the-mad-hatters/defcon2024badge/hardware/mad_hatter_lower_back_v3.png

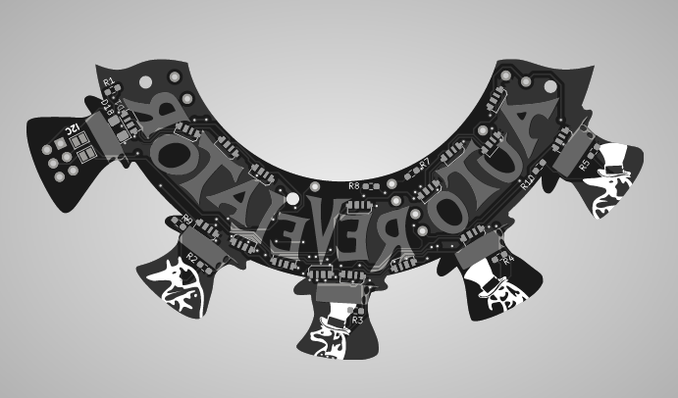
hardware/mad_hatter_lower_back_v3.png
