the-mad-hatters/defcon2024badge/hardware/mad_hatter_main_back.png

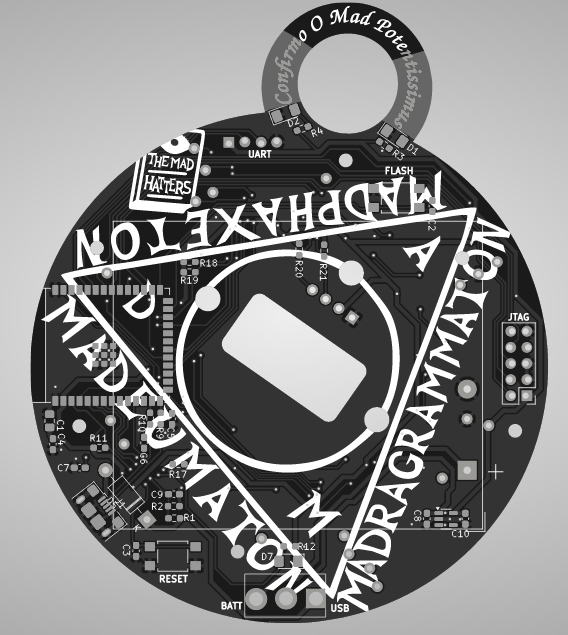
hardware/mad_hatter_main_back.png
