the-mad-hatters/defcon2024badge/README.md

# defcon2024badge

See https://madhatters.lol for details

The Mad Hatter Auto Revelator badge and Madragrammaton SAO will be available at the Hacker Warehouse at DC32.
