the-mad-hatters/defcon2024badge/stl/README.md

3D-Print: Top Hats and Adapters

* Print-ready for badge: :point_right: `tophat_dc32_badge.stl`

* Print-ready for SAO: :point_right: `tophat_dc32_sao.stl`

  * https://www.printables.com/model/935801

  * This work is licensed under a Creative Commons (4.0 International License) Attribution

    * ✖ | Sharing without ATTRIBUTION
    * ✔ | Remix Culture allowed
    * ✔ | Commercial Use
    * ✔ | Free Cultural Works
    * ✔ | Meets Open Definition

  * Remixed from (Attribution for original source creator: lytta, CC 4.0): https://www.printables.com/en/model/537438

* Adapter for swapping out hats - board side: :point_right: `madhatter_board_adapter.stl`

* Adapter for swapping out hats - hat side: :point_right: `madhatter_hat_adapter.stl`

  * https://www.printables.com/model/964691

  * This work is licensed under a Creative Commons (4.0 International License) Attribution-ShareAlike

    * ✖ | Sharing without ATTRIBUTION
    * ✔ | Remix Culture allowed
    * ✔ | Commercial Use
    * ✔ | Free Cultural Works
    * ✔ | Meets Open Definition

  * Remixed from (Attribution for original source creator: Mat, CC 4.0): https://www.printables.com/model/501739
