the-mad-hatters/defcon2024badge/hardware/mad_hatter_main_front.png

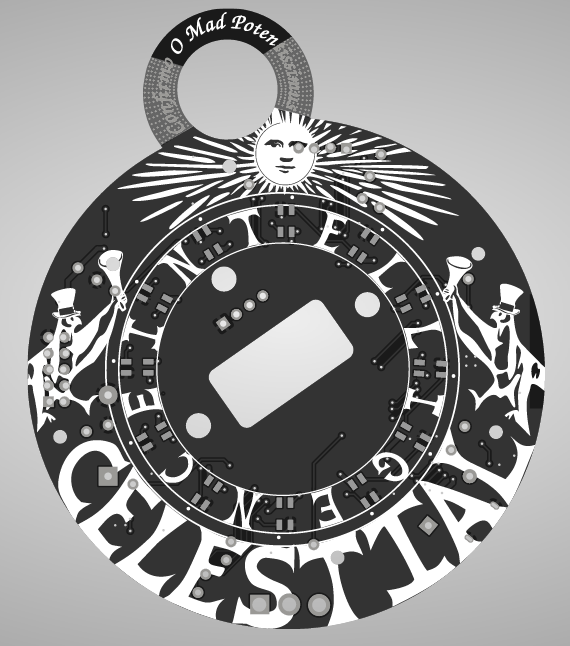
hardware/mad_hatter_main_front.png
