the-mad-hatters/defcon2024badge/hardware/mad_hatter_upper_front_v3.png

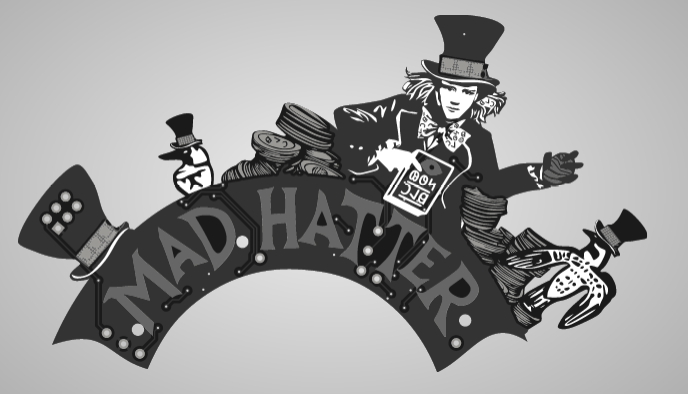
hardware/mad_hatter_upper_front_v3.png
