the-mad-hatters/defcon2024badge/hardware/mad_hatter_bom.xlsx

Board | Refdes | Description | Manufacturer | Part Number | Supplier | Package | Qty per Board | First Option | Second Option
main | BT1 | Battery Holder 3xAA | Eagle Plastic Devices | 12BH331P-GR | Mouser |  | 1 | https://www.mouser.com/ProductDetail/Eagle-Plastic-Devices/12BH331P-GR
main | C1 | 22uF Capacitor (ceramic, 10V, X5R) | Samsung Electro-Mechanics | CL21A226MPQNNNE | Digikey | 0805 | 1 | https://www.digikey.com/en/products/detail/samsung-electro-mechanics/CL21A226MPQNNNE/3888568
main | C5, C6 | NC |  |  |  | 0603 | 0
main | C2, C3, C4 , C9 | 0.1uF Capacitor (100nF) | Murata | GRM033Z71C104KE14J | Mouser | 0603 | 4 | https://www.mouser.com/ProductDetail/Murata-Electronics/GRM033Z71C104KE14J?qs=lEfY3O89AqkOnRdov738ag%3D%3D
main | C8, C10, C7 | 1uF capacitor (X7R) | Murata | GRT188R71E105KE13D | Digikey | 0603 | 3 | https://www.digikey.com/en/products/detail/murata-electronics/GRT188R71E105KE13D/10694256
main | D5 | schottky diode 40V 1A | STMicroelectronics | 1N5819 | Digikey | DO-41 | 1 | https://www.digikey.com/en/products/detail/stmicroelectronics/1N5819/1037326
main | D7 | LED - UV - power indicator |  |  |  | 1206 | 1 | https://www.aliexpress.us/item/2255800277083773.html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
main | D8, D9, D10, D11, D12, D13, D14, D15, D16, D17, D18, D19 | normal mount addressable LEDs - these aren't mounted how you'd think.. the cutout on the LED goes on the opposite corner from the white dot (PCB marking). |  | SK6812MINI | aliexpress | 3535 | 12 | https://www.aliexpress.us/item/2251832595980462.html | https://www.digikey.com/en/products/detail/adafruit-industries-llc/2659/5804108
main | J1 | Micro USB 2.0 | Amphenol ICC | 10118193-0001LF | Digikey |  | 1 | https://www.digikey.com/en/products/detail/amphenol-cs-fci/10118193-0001LF/2785388
main | J4 | I2C 0.96" OLED Display Module 128x64 |  |  | aliexpress |  | 1 | https://www.aliexpress.com/item/1005006085392157.html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
upper | Q1, Q2, Q3, Q4 | NPN 200mA, 40V transistor | MMB | MMBT3904 | Mouser | SOT-23 | 4 | https://www.mouser.com/ProductDetail/Diotec-Semiconductor/MMBT3904?qs=OlC7AqGiEDkK1MwiyUU6mg%3D%3D
main | R1 | 576k ohm | Bournes | CR0603-FX-5763ELF | Digikey | 0603 | 1 | https://www.digikey.com/en/products/detail/bourns-inc/CR0603-FX-5763ELF/3784105
main | R2 | 330k ohm | Yageo | RC0603FR-07330KL | Digikey | 0603 | 1 | https://www.digikey.com/en/products/detail/yageo/RC0603FR-07330KL/727163
main | R11, R17 | 10k ohm | Yageo | AF0603FR-0710KL | Mouser | 0603 | 2 | https://www.mouser.com/ProductDetail/YAGEO/AF0603FR-0710KL
main | R12 | 15 ohm |  |  |  | 0603 | 1
main | R18, R19, R20, R21 | 4.7k ohm - pull up resistors for I2C SAO and OLED |  |  |  | 0603 | 4
main | SW1, SW2 | pushbutton switches for Flash and Reset | Button_Switch_SMD:SW_SPST_TL3305A |  | digikey |  | 2 | https://www.digikey.com/en/products/detail/e-switch/TL3305AF260QG/5816184
main | SW3 | SPDT switch between battery and usb | CUI Devices | SLW-1276864-4A-D | Mouser |  | 1 | https://www.mouser.com/ProductDetail/CUI-Devices/SLW-1276864-4A-D?qs=1Kr7Jg1SGW90vOt02EYiag%3D%3D
main | U2 | LDO voltage regulator | Torex | XC6210B332MR-G | Mouser | SOT-25-5 | 1 | https://www.mouser.com/ProductDetail/Torex-Semiconductor/XC6210B332MR-G?qs=AsjdqWjXhJ%2FS4LOuBYdYHQ%3D%3D
main | U3 | esp32-s2 microcontroller | Espressif | ESP32-S2-SOLO-2-N4R2 | Digikey | 41-SMD Module | 1 | https://www.digikey.com/en/products/detail/espressif-systems/ESP32-S2-SOLO-2-N4R2/16591896
upper, lower | upper (D1, D2, D3, D4, D5, D6, D7, D8, D9), lower(D1 - D17) | side fire addressable LEDs |  | SK6812-SIDE-A | aliexpress |  | 26 | https://www.aliexpress.us/item/2261799823015387.html
upper | D16 | yellow LED |  |  | Mouser | 1206 | 1 | https://www.mouser.com/ProductDetail/Lite-On/LTST-C230KSKT?qs=VAsDcOInModG61IRQ3M7BA%3D%3D
upper | D10 | yellow LED in mad hatter hand (R10) |  |  | Mouser | 0805 | 1 | https://www.mouser.com/ProductDetail/ams-OSRAM/LY-R976-PS-36
main, upper, lower | main(D1, D2), upper(D11, D13, D14, D15), lower(D18) | red LEDs - hat bands, SAOs |  |  | Digikey | 1206 | 7 | https://www.digikey.com/en/products/detail/liteon/LTST-C230CKT/269233
main, upper, lower | main(R3, R4), upper(R1, R2, R3, R4, R5, R10), lower(R1) | 100 ohm resistors |  |  | Mouser | 0603 | 9 | https://www.mouser.com/ProductDetail/Walsin/WR06X101-JTL?qs=1w%252B2sDiFrrEiVQqOEsKZ4w%3D%3D
lower | R2, R3, R4, R5 | 1M ohm, touch button resistors |  |  | Mouser | 0603 | 4 | https://www.mouser.com/ProductDetail/Kamaya/RMC1-16-1R00FTP?qs=KAq9QXcE8HAYu9giRAIDyg%3D%3D
main, upper, lower | main(R9, R10), upper (R6, R7, R8, R9), lower(R7, R8, R9, R10) | 0 ohm resistors |  |  | Mouser | 0603 | 10 | https://www.mouser.com/ProductDetail/Kamaya/RMC16JPTP?qs=sGAEpiMZZMtlubZbdhIBIOD4JJV6Rved9NrdLu8OrNg%3D
main, lower | main-J3, lower-J1 | single pin female header, tall |  |  | Digikey |  | 19 | https://www.digikey.com/en/products/detail/samtec-inc/SSW-101-01-T-S/1112304
main, upper | main-J6, upper-J1 | single pin male header (9-position x 220 = 1,980, need 1900) |  |  | Digikey |  | 19 | https://www.digikey.com/en/products/detail/sullins-connector-solutions/S9691E-09/6827602
main, upper, lower |  | PCBs |  |  | jlcpcb |  | 1
main, upper, lower |  | M2 x 16mm black hex socket head cap screws/nuts |  |  | Amazon |  | 6 | https://www.amazon.com/dp/B0CL6YT53F?ref=ppx_yo2ov_dt_b_product_details&th=1 | https://www.amazon.com/gp/product/B0CMG7Q27P/ref=ppx_yo_dt_b_asin_title_o01_s00?ie=UTF8&psc=1
upper, lower | J2 | SAO Connector |  |  |  |  | 2 | https://www.digikey.com/en/products/detail/sullins-connector-solutions/SFH11-NBPC-D03-ST-BK/4558818
main |  | 3 AA batteries |  |  | Amazon |  | 3 | https://www.amazon.com/dp/B07VMMY9F5
 |  | 3d printed hat |  |  |  |  | 1
 |  | lanyard (plastic connector) |  |  |  |  | 1
 |  | antistatic bags (10x8 inches) |  |  |  |  | 1
 |  | sticky tape for battery |  |  | Amazon
 |  | M2 black nylon washers (for attaching hat to PCB) | Helifouner |  | Amazon |  | 3 | https://www.amazon.com/gp/product/B0BNBPTSMP/
 |  | M2 4mm screws (for attaching hat to PCB) | XunLiu |  | Amazon |  | 3 | https://www.amazon.com/gp/product/B07CHM7ZQK/?th=1
