the-mad-hatters/defcon2024badge/stl/madhatter_hat_adapter.stl

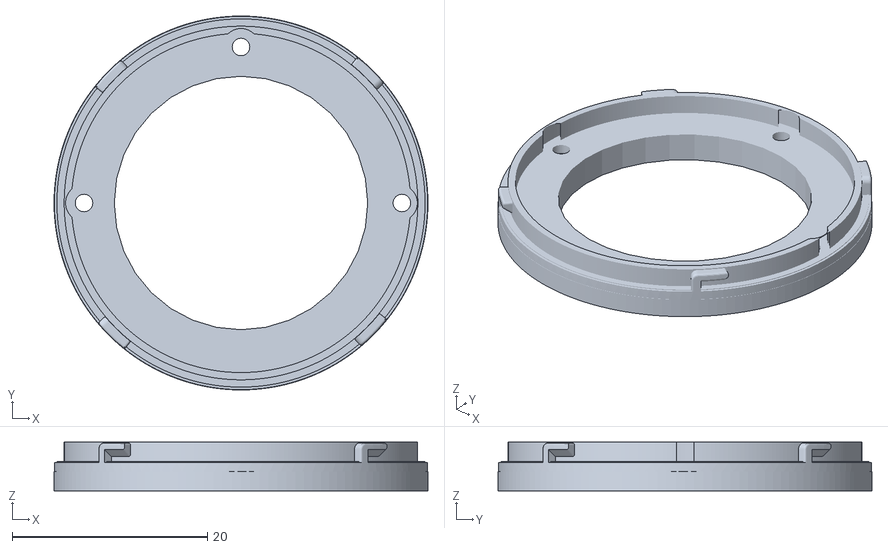
[picture p6: CAD file, 2024-08-05]
stl/madhatter_hat_adapter.stl
38.4 x 38.4 x 5.00
