the-mad-hatters/defcon2024badge/stl/madhatter_board_adapter.stl

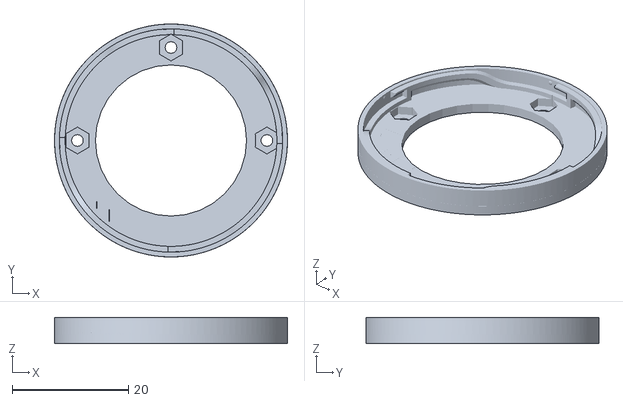
[picture p7: CAD file, 2024-08-05]
stl/madhatter_board_adapter.stl
40.1 x 40.1 x 4.52
