the-mad-hatters/defcon2024badge/hardware/mad_hatter_bottom_text.kicad_pcb

## KiCad design hardware/mad_hatter_bottom_text.kicad_pcb (2024-06-27)

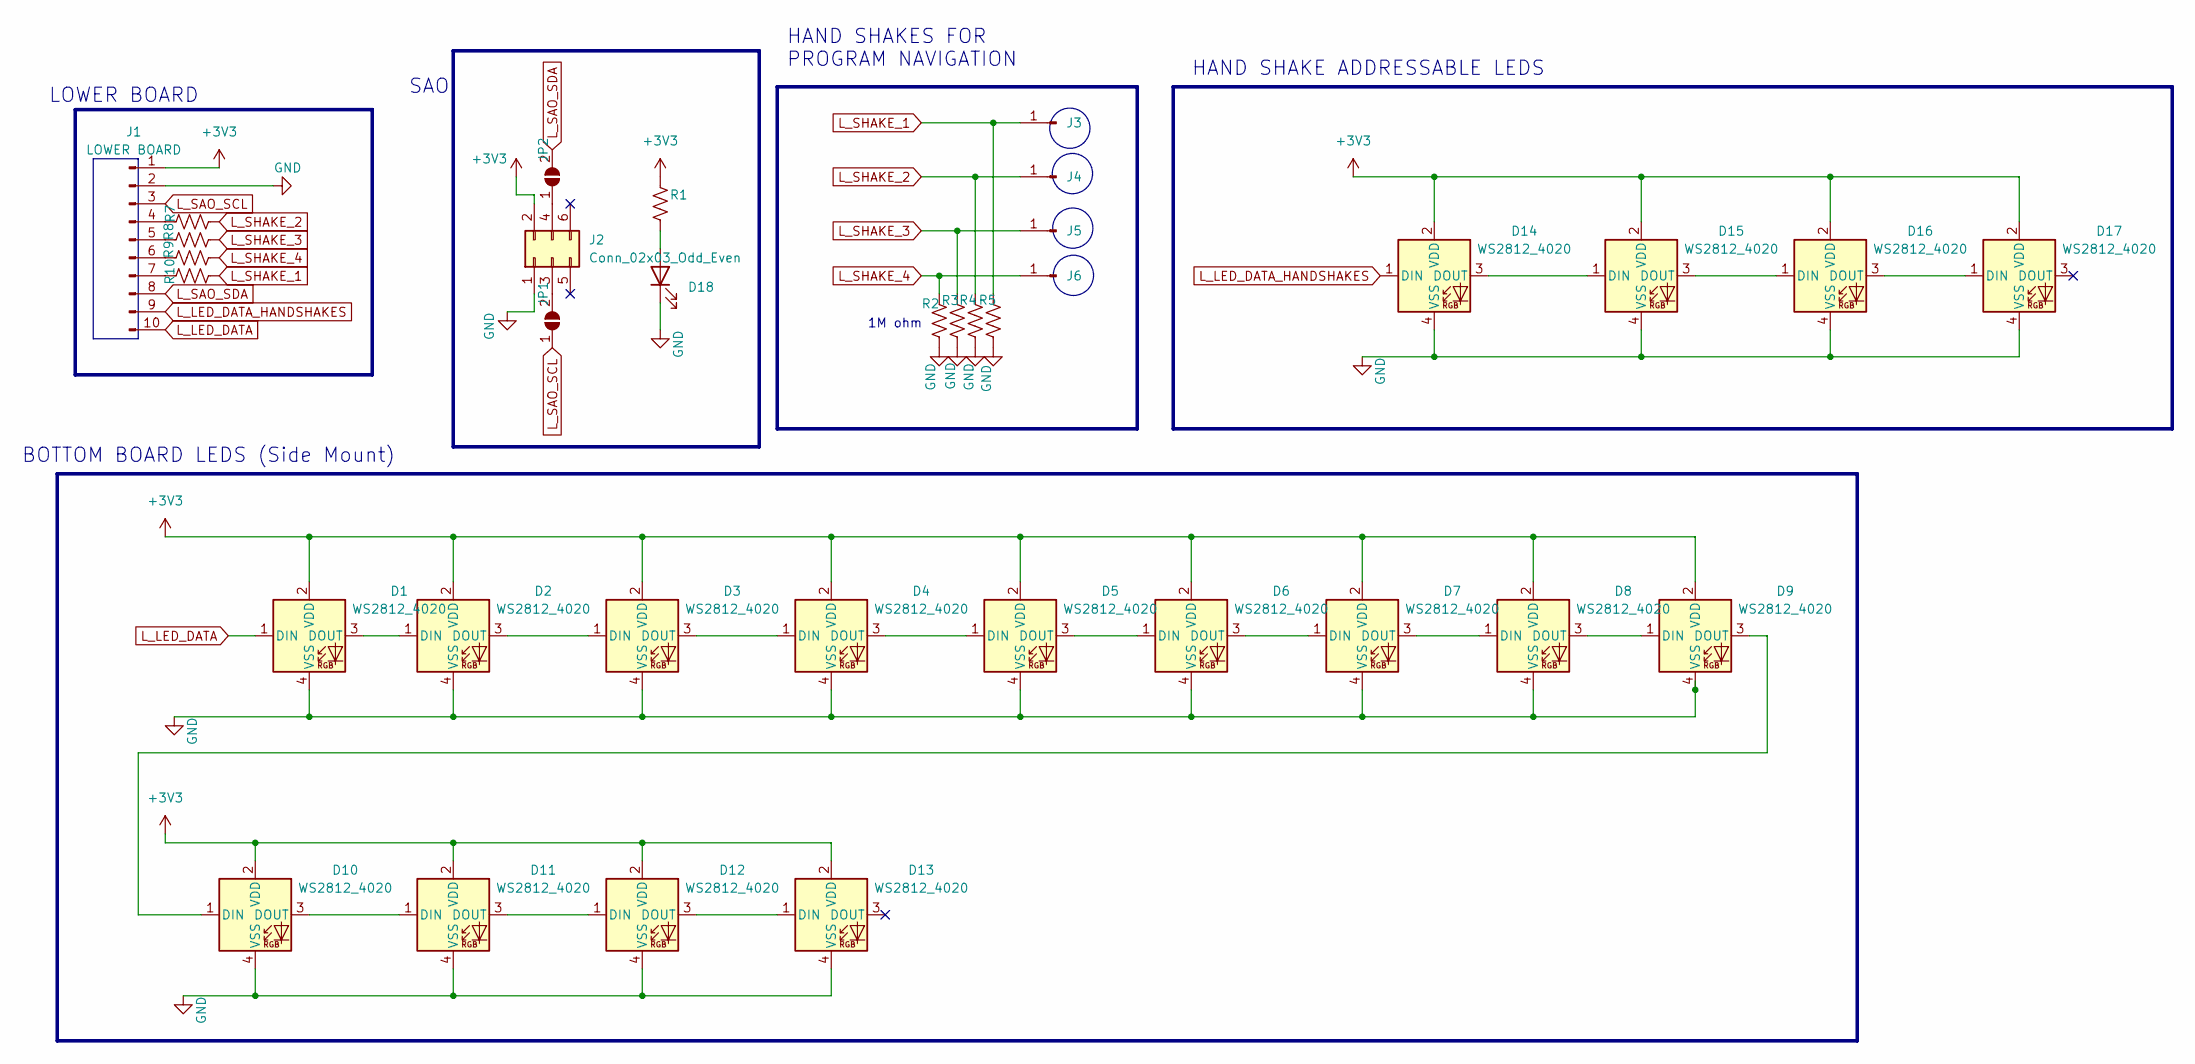
[picture p8: schematic mad_hatter_bottom_text.kicad_sch]

Parts:
D1, D2, D3, D4, D5, D6, D7, D8, D9, D10, D11, D12, D13, D14, D15, D16, D17: WS2812_4020; sk6812-side-a
D18: LED; LED_1206_3216Metric_Pad1.42x1.75mm_HandSolder
J1: LOWER BOARD; mad_hatter_lower_board_connector
J2: Conn_02x03_Odd_Even; sao_footprint
J3, J4, J5, J6: Conn_01x01_Pin; mad_hatter_touch_button
JP1, JP2: SolderJumper_2_Open; SolderJumper-2_P1.3mm_Open_Pad1.0x1.5mm
R1, R2, R3, R4, R5, R7, R8, R9, R10: R_US; R_0603_1608Metric_Pad0.98x0.95mm_HandSolder

Connections:
+3V3: D1.2 (VDD), D2.2 (VDD), D3.2 (VDD), D4.2 (VDD), D5.2 (VDD), D6.2 (VDD), D7.2 (VDD), D8.2 (VDD), D9.2 (VDD), D10.2 (VDD), D11.2 (VDD), D12.2 (VDD), D13.2 (VDD), D14.2 (VDD), D15.2 (VDD), D16.2 (VDD), D17.2 (VDD), J1.1, J2.2, R1.1
GND: D1.4 (VSS), D2.4 (VSS), D3.4 (VSS), D4.4 (VSS), D5.4 (VSS), D6.4 (VSS), D7.4 (VSS), D8.4 (VSS), D9.4 (VSS), D10.4 (VSS), D11.4 (VSS), D12.4 (VSS), D13.4 (VSS), D14.4 (VSS), D15.4 (VSS), D16.4 (VSS), D17.4 (VSS), D18.1 (K), J1.2, J2.1, R2.2, R3.2, R4.2, R5.2
L_LED_DATA: D1.1 (DIN), J1.10
L_LED_DATA_HANDSHAKES: D14.1 (DIN), J1.9
L_SAO_SCL: J1.3, JP1.1 (A)
L_SAO_SDA: J1.8, JP2.2 (B)
L_SHAKE_1: J3.1, R5.1, R10.1
L_SHAKE_2: J4.1, R4.1, R7.1
L_SHAKE_3: J5.1, R3.1, R8.1
L_SHAKE_4: J6.1, R2.1, R9.1
unnamed: D1.3 (DOUT), D2.1 (DIN)
unnamed: D2.3 (DOUT), D3.1 (DIN)
unnamed: D3.3 (DOUT), D4.1 (DIN)
unnamed: D4.3 (DOUT), D5.1 (DIN)
unnamed: D5.3 (DOUT), D6.1 (DIN)
unnamed: D6.3 (DOUT), D7.1 (DIN)
unnamed: D7.3 (DOUT), D8.1 (DIN)
unnamed: D8.3 (DOUT), D9.1 (DIN)
unnamed: D9.3 (DOUT), D10.1 (DIN)
unnamed: D10.3 (DOUT), D11.1 (DIN)
unnamed: D11.3 (DOUT), D12.1 (DIN)
unnamed: D12.3 (DOUT), D13.1 (DIN)
unnamed: D14.3 (DOUT), D15.1 (DIN)
unnamed: D15.3 (DOUT), D16.1 (DIN)
unnamed: D16.3 (DOUT), D17.1 (DIN)
unnamed: D18.2 (A), R1.2
unnamed: J1.4, R7.2
unnamed: J1.5, R8.2
unnamed: J1.6, R9.2
unnamed: J1.7, R10.2
unnamed: J2.3, JP1.2 (B)
unnamed: J2.4, JP2.1 (A)

Notes on the sheet:
HAND SHAKES FOR PROGRAM NAVIGATION
LOWER BOARD
SAO
HAND SHAKE ADDRESSABLE LEDS
BOTTOM BOARD LEDS (Side Mount)
1M ohm

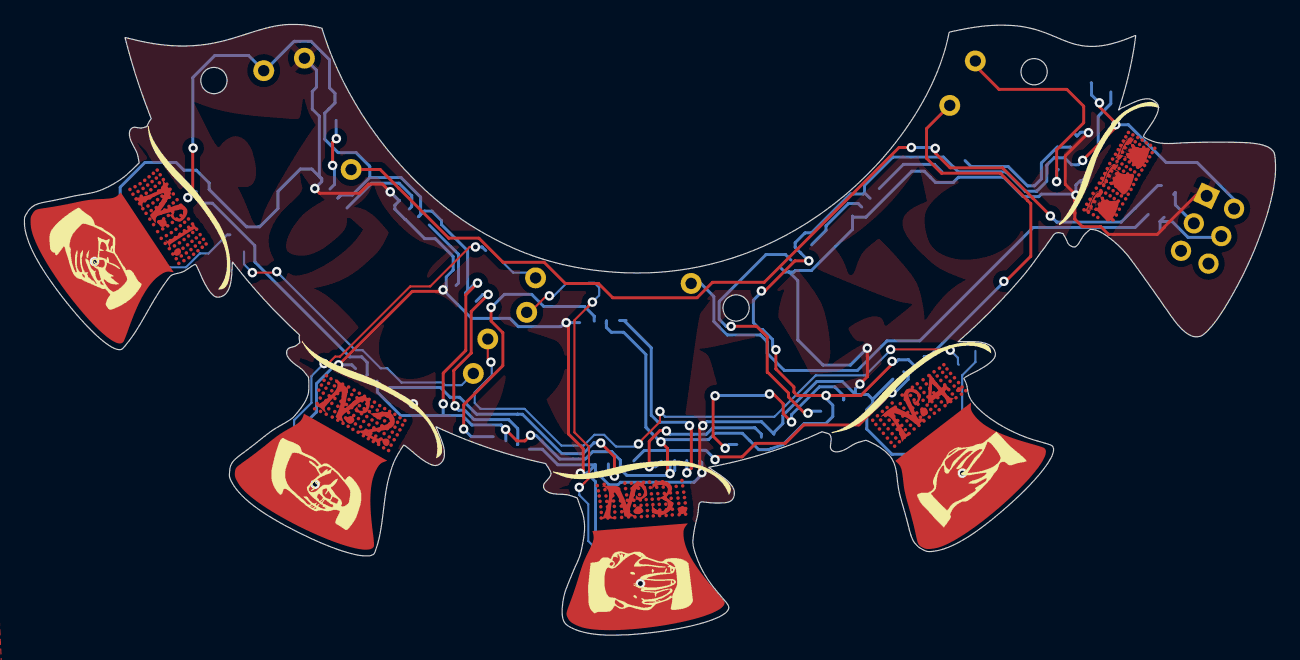
[picture p9: board mad_hatter_bottom_text.kicad_pcb from above]

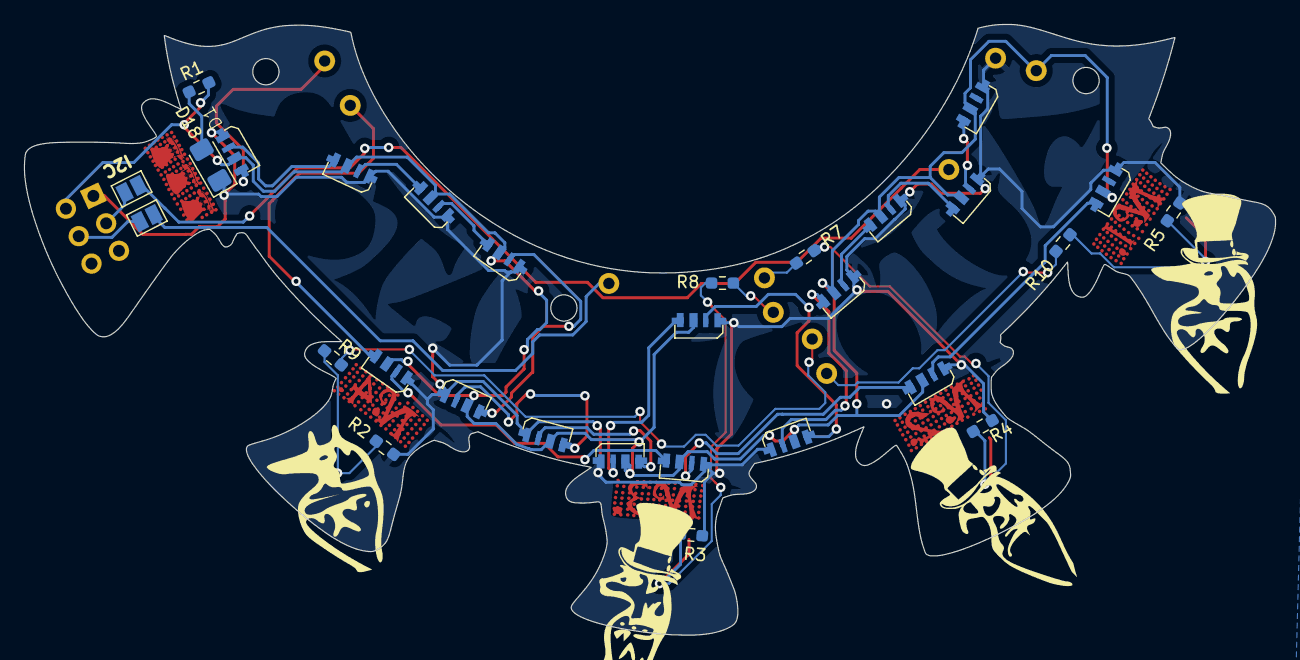
[picture p10: board mad_hatter_bottom_text.kicad_pcb from below]

Board: 2 copper layers, 104.9 x 51.2 mm, 35 parts (29 on the bottom side), 32 nets.
