the-mad-hatters/defcon2024badge/hardware/mad_hatter_top_text_board.kicad_pcb

## KiCad design hardware/mad_hatter_top_text_board.kicad_pcb (2024-06-27)

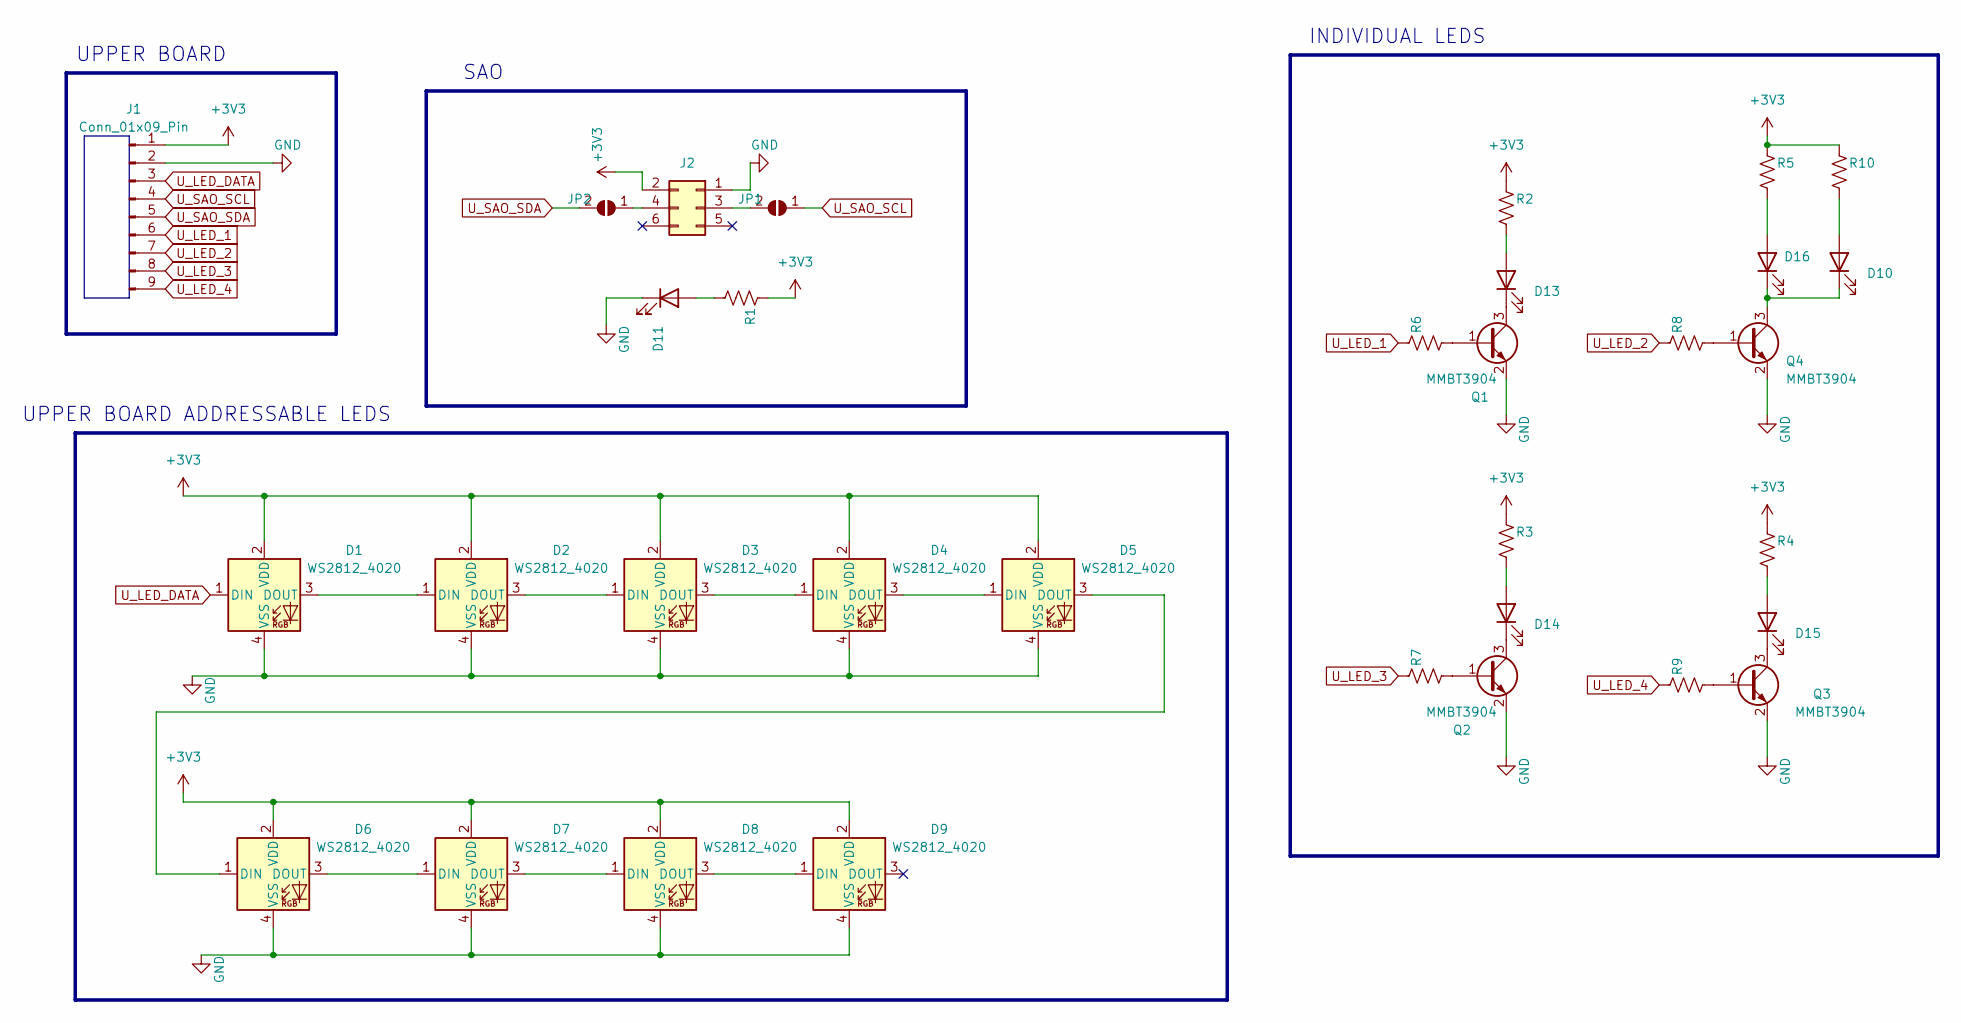
[picture p11: schematic mad_hatter_top_text_board.kicad_sch]

Parts:
D1, D2, D3, D4, D5, D6, D7, D8, D9: WS2812_4020; sk6812-side-a
D10: LED; LED_0805_2012Metric_Pad1.15x1.40mm_HandSolder
D11, D13, D14, D15, D16: LED; LED_1206_3216Metric_Pad1.42x1.75mm_HandSolder
J1: Conn_01x09_Pin; mad_hatter_upper_board_connector
J2: Conn_02x03_Odd_Even; sao_footprint
JP1, JP2: SolderJumper_2_Open; SolderJumper-2_P1.3mm_Open_Pad1.0x1.5mm
Q1, Q2, Q3, Q4: MMBT3904; SOT-23
R1, R2, R3, R4, R5, R6, R7, R8, R9, R10: R_US; R_0603_1608Metric_Pad0.98x0.95mm_HandSolder

Connections:
+3V3: D1.2 (VDD), D2.2 (VDD), D3.2 (VDD), D4.2 (VDD), D5.2 (VDD), D6.2 (VDD), D7.2 (VDD), D8.2 (VDD), D9.2 (VDD), J1.1, J2.2, R1.1, R2.1, R3.1, R4.1, R5.1, R10.1
GND: D1.4 (VSS), D2.4 (VSS), D3.4 (VSS), D4.4 (VSS), D5.4 (VSS), D6.4 (VSS), D7.4 (VSS), D8.4 (VSS), D9.4 (VSS), D11.1 (K), J1.2, J2.1, Q1.2 (E), Q2.2 (E), Q3.2 (E), Q4.2 (E)
unnamed: D1.3 (DOUT), D2.1 (DIN)
unnamed: D2.3 (DOUT), D3.1 (DIN)
unnamed: D3.3 (DOUT), D4.1 (DIN)
unnamed: D4.3 (DOUT), D5.1 (DIN)
unnamed: D5.3 (DOUT), D6.1 (DIN)
unnamed: D6.3 (DOUT), D7.1 (DIN)
unnamed: D7.3 (DOUT), D8.1 (DIN)
unnamed: D8.3 (DOUT), D9.1 (DIN)
unnamed: D10.2 (A), R10.2
unnamed: D10.1 (K), D16.1 (K), Q4.3 (C)
unnamed: D11.2 (A), R1.2
unnamed: D13.2 (A), R2.2
unnamed: D13.1 (K), Q1.3 (C)
unnamed: D14.2 (A), R3.2
unnamed: D14.1 (K), Q2.3 (C)
unnamed: D15.2 (A), R4.2
unnamed: D15.1 (K), Q3.3 (C)
unnamed: D16.2 (A), R5.2
unnamed: J2.3, JP1.2 (B)
unnamed: J2.4, JP2.1 (A)
unnamed: Q1.1 (B), R6.2
unnamed: Q2.1 (B), R7.2
unnamed: Q3.1 (B), R9.2
unnamed: Q4.1 (B), R8.2
U_LED_1: J1.6, R6.1
U_LED_2: J1.7, R8.1
U_LED_3: J1.8, R7.1
U_LED_4: J1.9, R9.1
U_LED_DATA: D1.1 (DIN), J1.3
U_SAO_SCL: J1.4, JP1.1 (A)
U_SAO_SDA: J1.5, JP2.2 (B)

Notes on the sheet:
UPPER BOARD
INDIVIDUAL LEDS
UPPER BOARD ADDRESSABLE LEDS
SAO

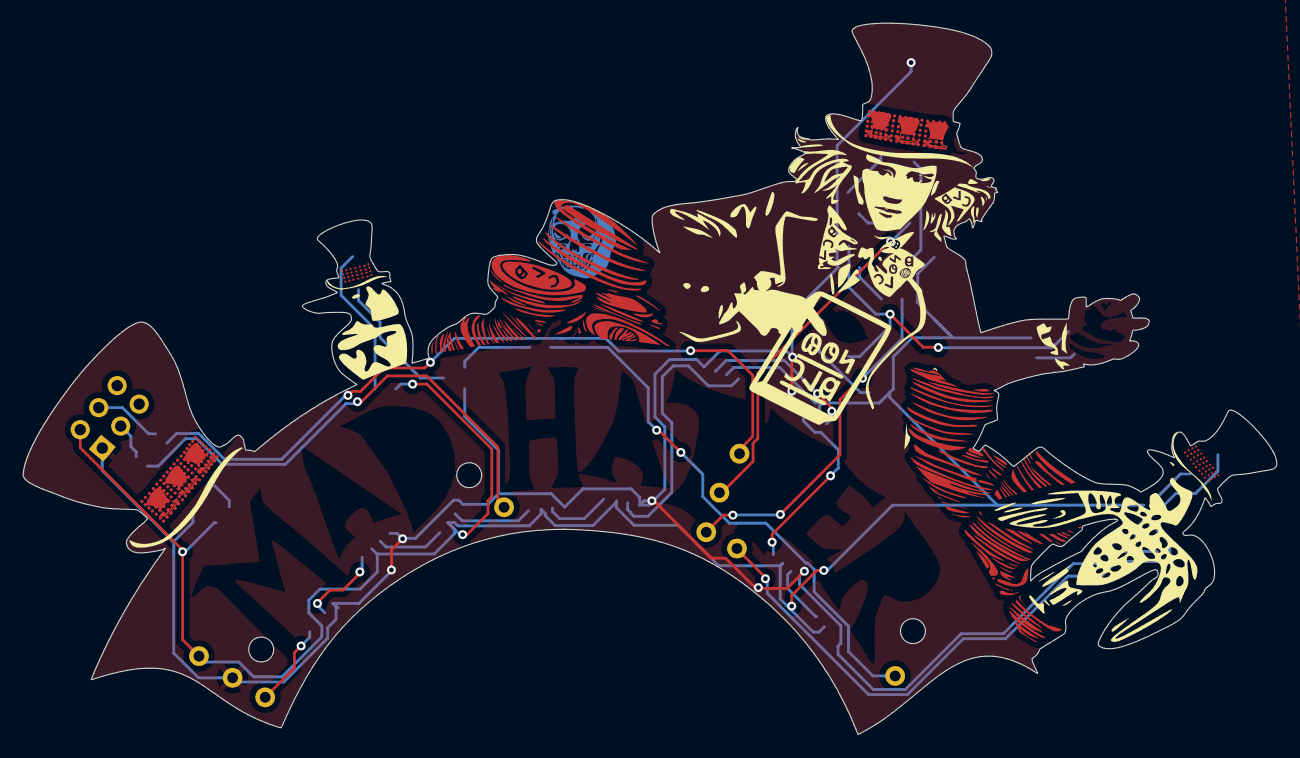
[picture p12: board mad_hatter_top_text_board.kicad_pcb from above]

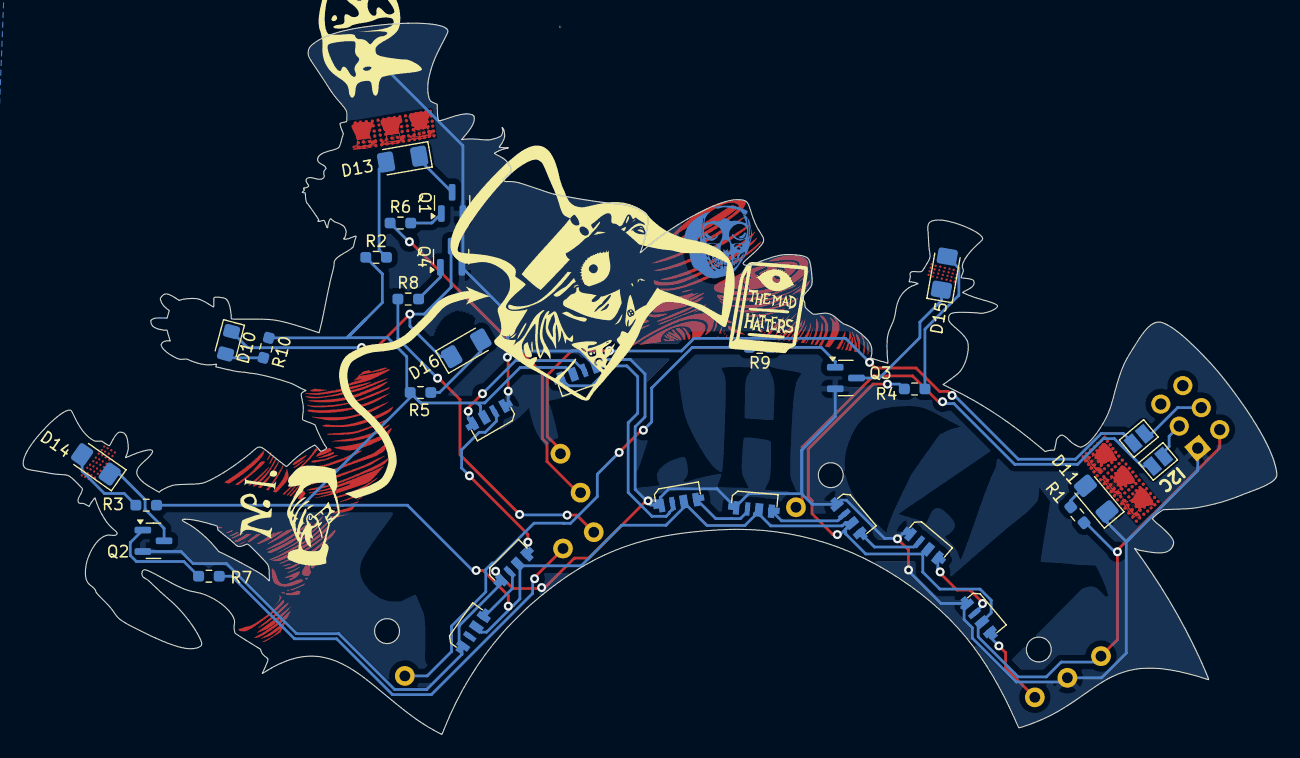
[picture p13: board mad_hatter_top_text_board.kicad_pcb from below]

Board: 2 copper layers, 110.8 x 62.9 mm, 33 parts (31 on the bottom side), 33 nets.
