the-mad-hatters/defcon2024badge/hardware/mad_hatter_main_board.kicad_pcb

## KiCad design hardware/mad_hatter_main_board.kicad_pcb (2024-06-27)

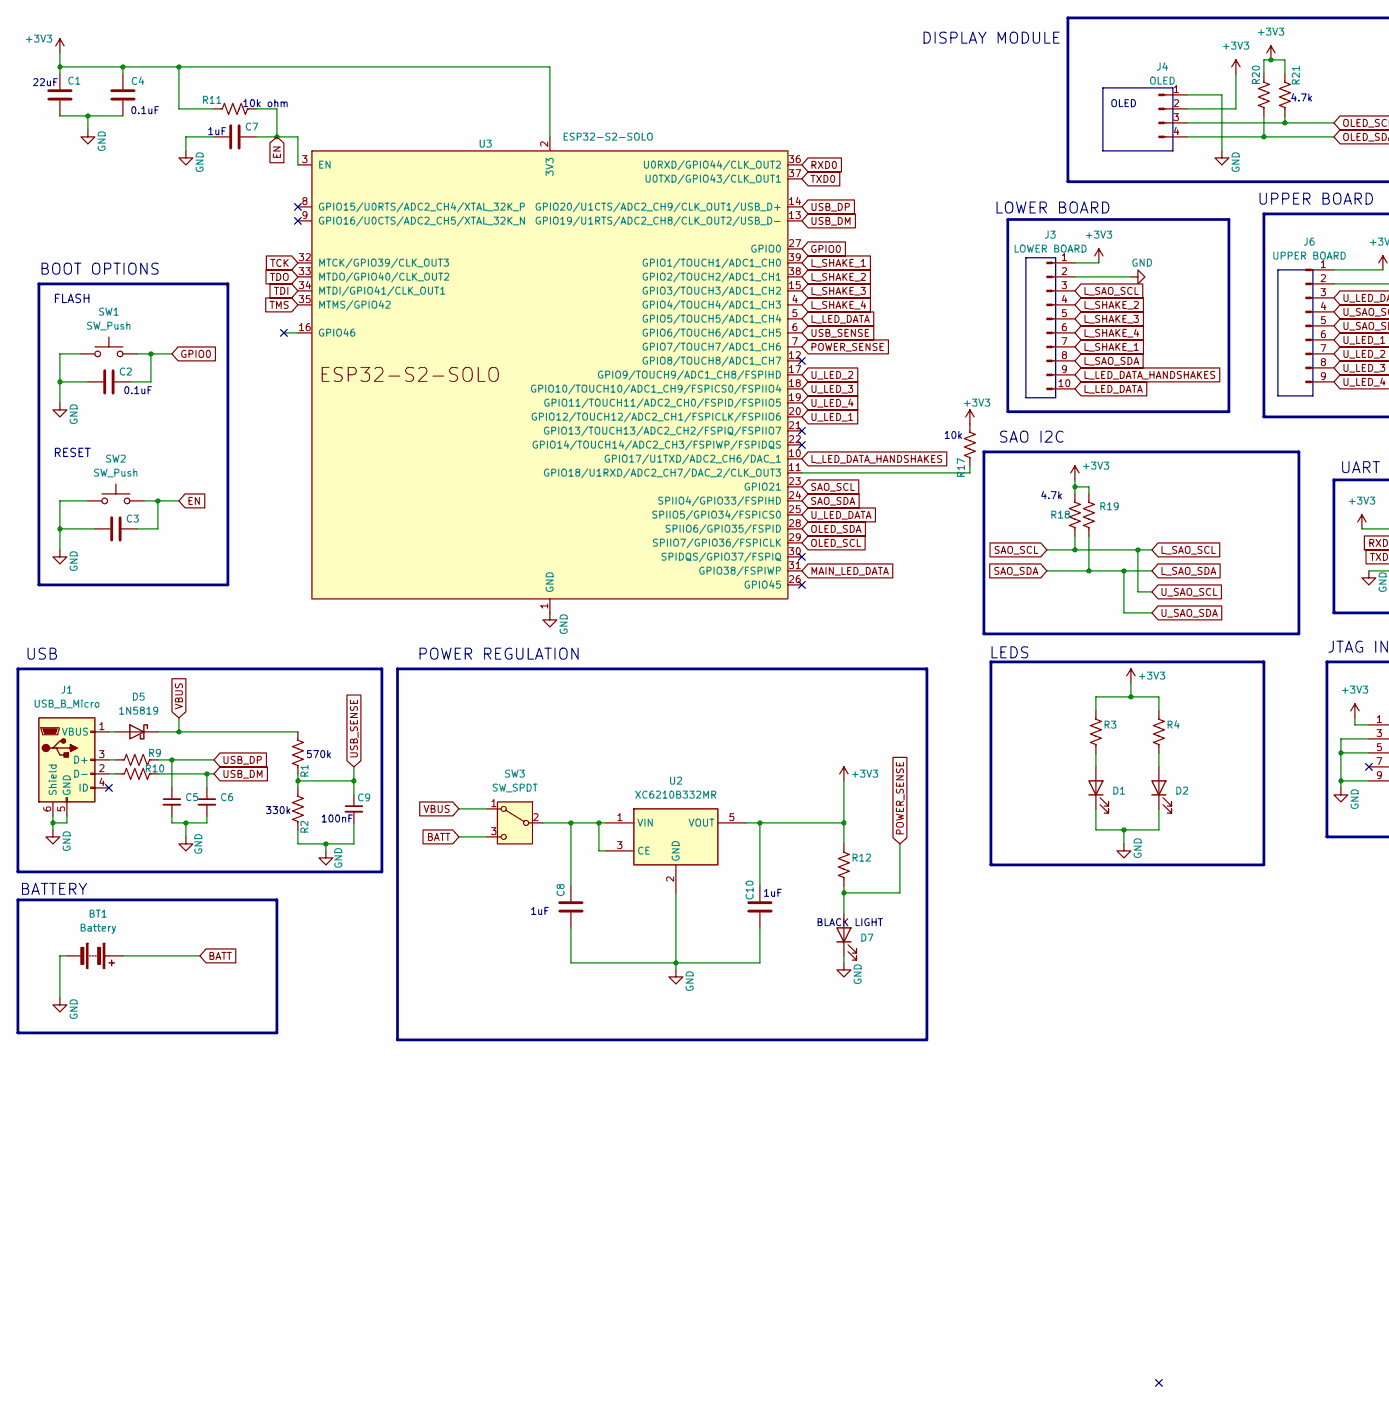
[picture p14: schematic mad_hatter_main_board.kicad_sch, part in row 1, column 1]

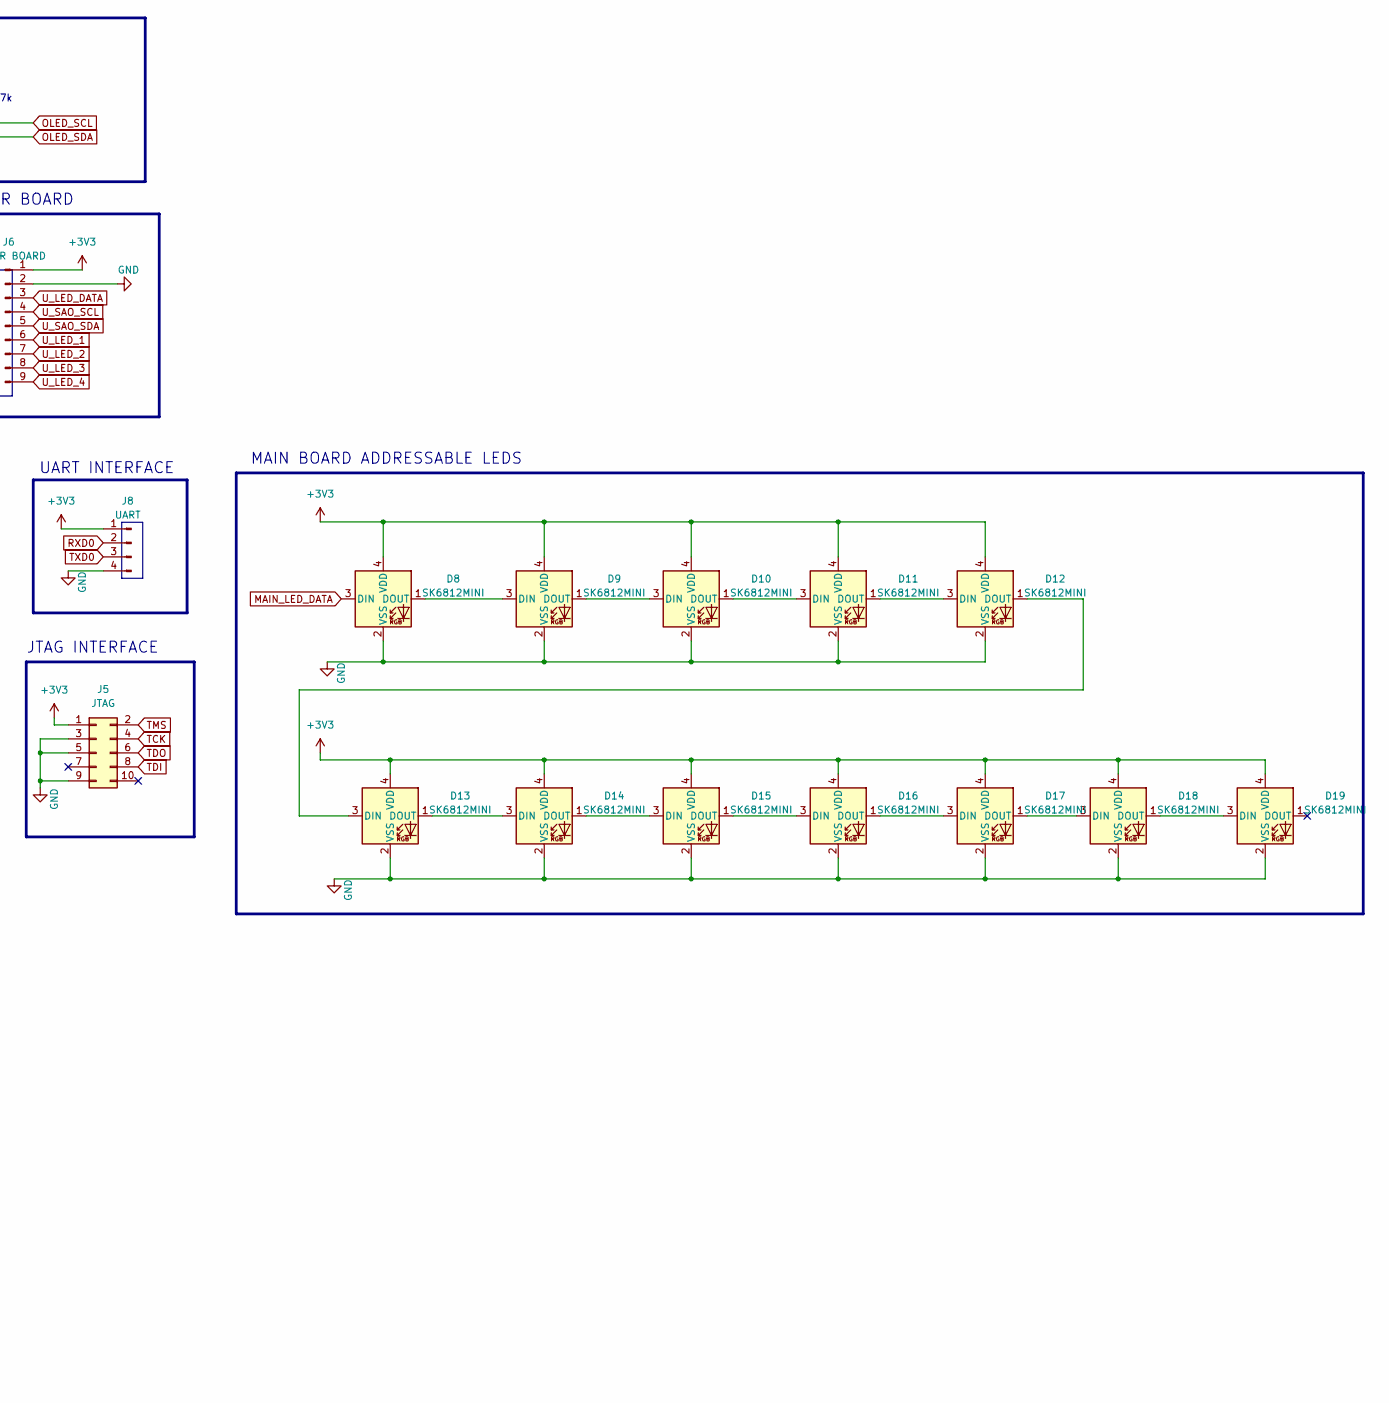
[picture p15: schematic mad_hatter_main_board.kicad_sch, part in row 1, column 2]

Parts:
BT1: Battery; mad_hatter_3_AA_battery
C1: C; C_0805_2012Metric_Pad1.18x1.45mm_HandSolder
C2, C3, C4, C7, C8, C10: C; C_0603_1608Metric_Pad1.08x0.95mm_HandSolder
C5, C6, C9: 10uF; C_0603_1608Metric_Pad1.08x0.95mm_HandSolder
D1, D2, D7: LED; LED_1206_3216Metric_Pad1.42x1.75mm_HandSolder
D5: 1N5819; D_DO-41_SOD81_P10.16mm_Horizontal
D8, D9, D10, D11, D12, D13, D14, D15, D16, D17, D18, D19: SK6812MINI; mad_hatter_sk6812mini
J1: USB_B_Micro; USB_Micro-B_Amphenol_10118193-0001LF_Horizontal
J3: LOWER BOARD; mad_hatter_lower_board_connector
J4: OLED; oled_display
J5: JTAG; mad_hatter_jtag_sneaky_connector
J6: UPPER BOARD; mad_hatter_upper_board_connector
J8: UART; mad_hatter_sneaky_uart_connector
R1, R2, R3, R4, R9, R10, R11, R12, R17, R18, R19, R20, R21: R_US; R_0603_1608Metric_Pad0.98x0.95mm_HandSolder
SW1, SW2: SW_Push; SW_SPST_TL3305A
SW3: SW_SPDT; mad_hatter_switch_2
U2: XC6210B332MR; SOT-23-5
U3: ESP32-S2-SOLO

Connections:
+3V3: C1.1, C4.1, C10.1, D8.4 (VDD), D9.4 (VDD), D10.4 (VDD), D11.4 (VDD), D12.4 (VDD), D13.4 (VDD), D14.4 (VDD), D15.4 (VDD), D16.4 (VDD), D17.4 (VDD), D18.4 (VDD), D19.4 (VDD), J3.1, J4.2, J5.1, J6.1, J8.1, R3.1, R4.1, R11.2, R12.1, R17.1, R18.1, R19.1, R20.2, R21.2, U2.5 (VOUT), U3.2 (3V3)
BATT: BT1.1 (+), SW3.3 (C)
EN: C3.1, C7.1, R11.1, SW2.2, U3.3 (EN)
GND: BT1.2 (-), C1.2, C2.2, C3.2, C4.2, C5.2, C6.2, C7.2, C8.2, C9.2, C10.2, D1.1 (K), D2.1 (K), D7.1 (K), D8.2 (VSS), D9.2 (VSS), D10.2 (VSS), D11.2 (VSS), D12.2 (VSS), D13.2 (VSS), D14.2 (VSS), D15.2 (VSS), D16.2 (VSS), D17.2 (VSS), D18.2 (VSS), D19.2 (VSS), J1.5 (GND), J1.6 (Shield), J3.2, J4.1, J5.3, J5.5, J5.9, J6.2, J8.4, R2.1, SW1.1, SW2.1, U2.2 (GND), U3.1 (GND), U3.40 (GND), U3.41 (GND)
GPIO0: C2.1, SW1.2, U3.27 (GPIO0)
L_LED_DATA: J3.10, U3.5 (GPIO5/TOUCH5/ADC1_CH4)
L_LED_DATA_HANDSHAKES: J3.9, U3.10 (GPIO17/U1TXD/ADC2_CH6/DAC_1)
L_SAO_SCL: J3.3, J6.4, R18.2, U3.23 (GPIO21)
L_SAO_SDA: J3.8, J6.5, R19.2, U3.24 (SPIIO4/GPIO33/FSPIHD)
L_SHAKE_1: J3.7, U3.39 (GPIO1/TOUCH1/ADC1_CH0)
L_SHAKE_2: J3.4, U3.38 (GPIO2/TOUCH2/ADC1_CH1)
L_SHAKE_3: J3.5, U3.15 (GPIO3/TOUCH3/ADC1_CH2)
L_SHAKE_4: J3.6, U3.4 (GPIO4/TOUCH4/ADC1_CH3)
MAIN_LED_DATA: D8.3 (DIN), U3.31 (GPIO38/FSPIWP)
unnamed: D1.2 (A), R3.2
unnamed: D2.2 (A), R4.2
unnamed: D5.2 (A), J1.1 (VBUS)
unnamed: D8.1 (DOUT), D9.3 (DIN)
unnamed: D9.1 (DOUT), D10.3 (DIN)
unnamed: D10.1 (DOUT), D11.3 (DIN)
unnamed: D11.1 (DOUT), D12.3 (DIN)
unnamed: D12.1 (DOUT), D13.3 (DIN)
unnamed: D13.1 (DOUT), D14.3 (DIN)
unnamed: D14.1 (DOUT), D15.3 (DIN)
unnamed: D15.1 (DOUT), D16.3 (DIN)
unnamed: D16.1 (DOUT), D17.3 (DIN)
unnamed: D17.1 (DOUT), D18.3 (DIN)
unnamed: D18.1 (DOUT), D19.3 (DIN)
unnamed: J1.3 (D+), R9.2
unnamed: J1.2 (D-), R10.2
unnamed: C8.1, SW3.2 (B), U2.1 (VIN), U2.3 (CE)
unnamed: R17.2, U3.11 (GPIO18/U1RXD/ADC2_CH7/DAC_2/CLK_OUT3)
OLED_SCL: J4.3, R21.1, U3.29 (SPIIO7/GPIO36/FSPICLK)
OLED_SDA: J4.4, R20.1, U3.28 (SPIIO6/GPIO35/FSPID)
POWER_SENSE: D7.2 (A), R12.2, U3.7 (GPIO7/TOUCH7/ADC1_CH6)
RXD0: J8.2, U3.36 (U0RXD/GPIO44/CLK_OUT2)
TCK: J5.4, U3.32 (MTCK/GPIO39/CLK_OUT3)
TDI: J5.8, U3.34 (MTDI/GPIO41/CLK_OUT1)
TDO: J5.6, U3.33 (MTDO/GPIO40/CLK_OUT2)
TMS: J5.2, U3.35 (MTMS/GPIO42)
TXD0: J8.3, U3.37 (U0TXD/GPIO43/CLK_OUT1)
USB_DM: C6.1, R10.1, U3.13 (GPIO19/U1RTS/ADC2_CH8/CLK_OUT2/USB_D-)
USB_DP: C5.1, R9.1, U3.14 (GPIO20/U1CTS/ADC2_CH9/CLK_OUT1/USB_D+)
USB_SENSE: C9.1, R1.1, R2.2, U3.6 (GPIO6/TOUCH6/ADC1_CH5)
U_LED_1: J6.6, U3.20 (GPIO12/TOUCH12/ADC2_CH1/FSPICLK/FSPIIO6)
U_LED_2: J6.7, U3.17 (GPIO9/TOUCH9/ADC1_CH8/FSPIHD)
U_LED_3: J6.8, U3.18 (GPIO10/TOUCH10/ADC1_CH9/FSPICS0/FSPIIO4)
U_LED_4: J6.9, U3.19 (GPIO11/TOUCH11/ADC2_CH0/FSPID/FSPIIO5)
U_LED_DATA: J6.3, U3.25 (SPIIO5/GPIO34/FSPICS0)
VBUS: D5.1 (K), R1.2, SW3.1 (A)

Notes on the sheet:
0.1uF
LEDS
BOOT OPTIONS
BATTERY
SAO I2C
UART INTERFACE
JTAG INTERFACE
10k ohm
POWER REGULATION
22uF
OLED
RESET
330k
MAIN BOARD ADDRESSABLE LEDS
4.7k
1uF
USB
570k
FLASH
100nF
10k
UPPER BOARD
DISPLAY MODULE
BLACK LIGHT
LOWER BOARD

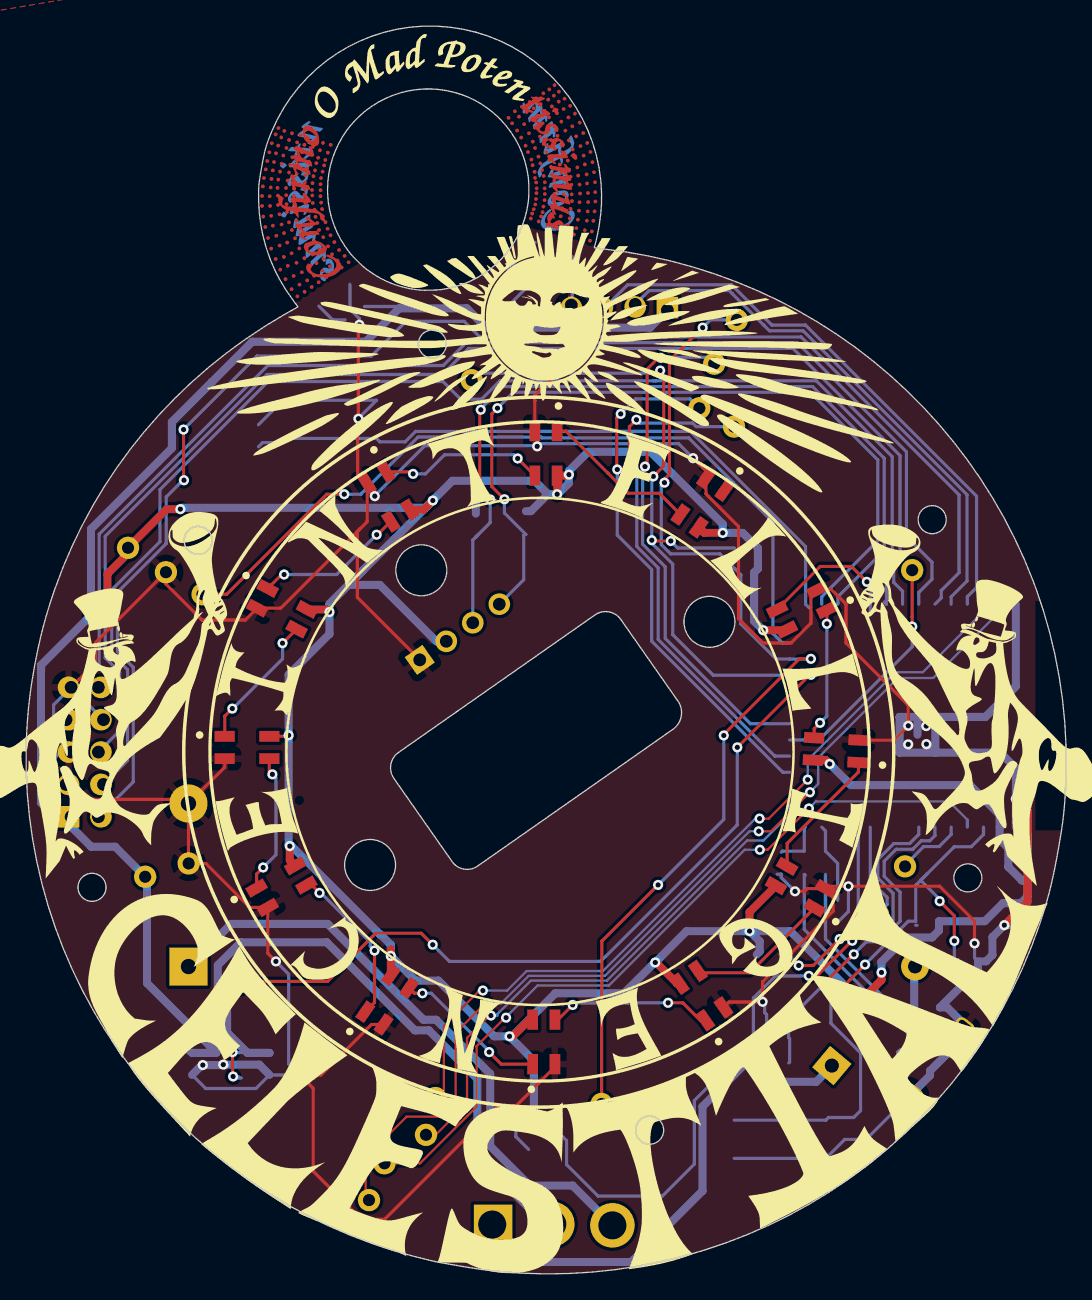
[picture p16: board mad_hatter_main_board.kicad_pcb from above]

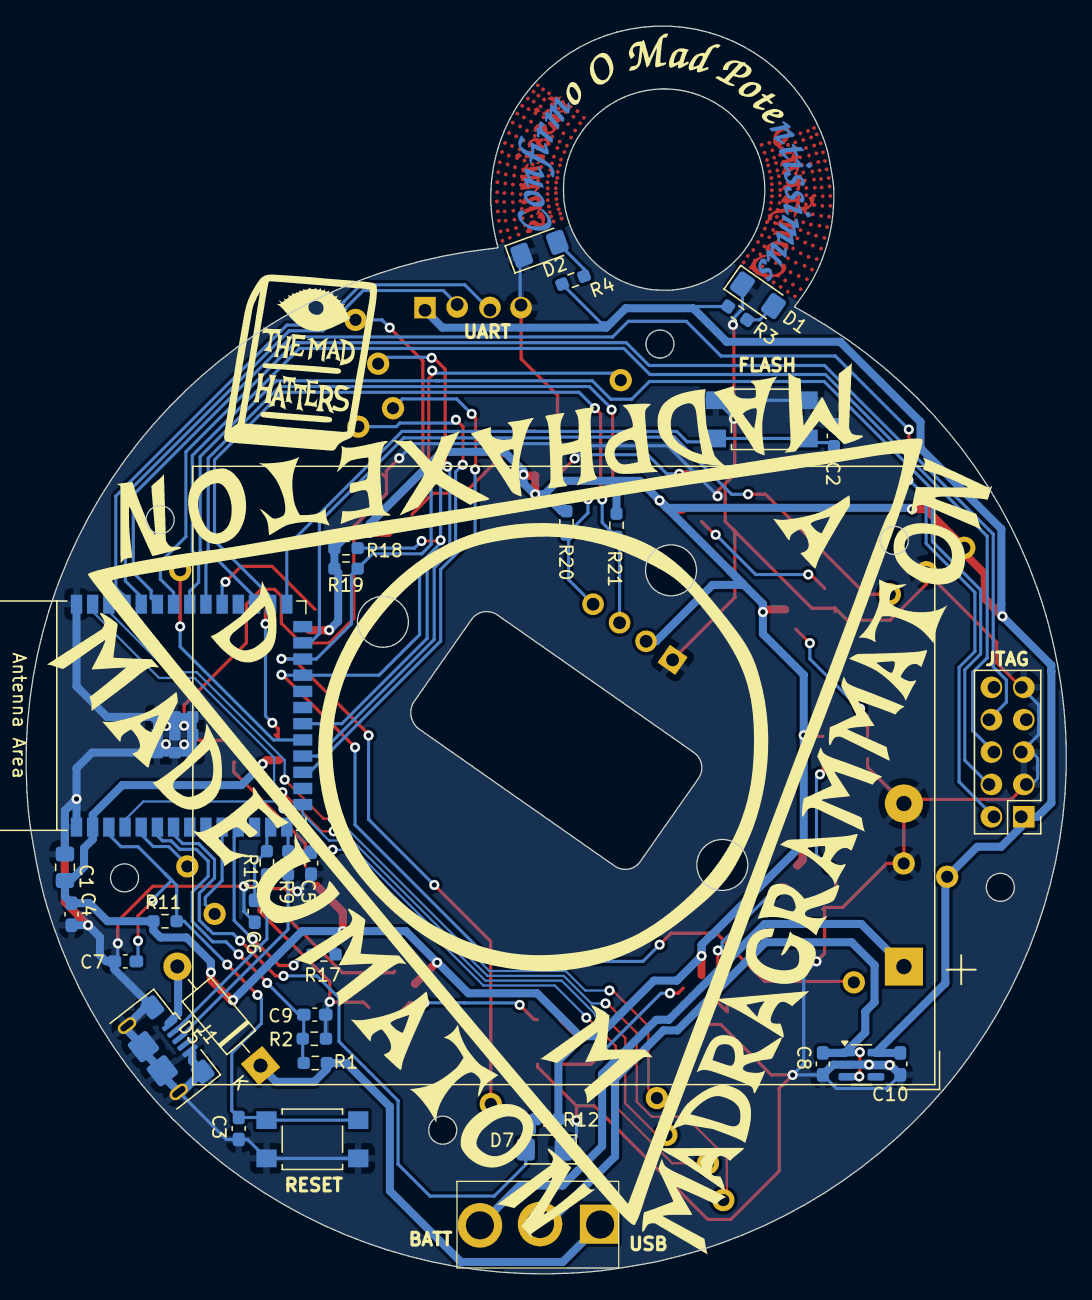
[picture p17: board mad_hatter_main_board.kicad_pcb from below]

Board: 2 copper layers, 81.6 x 97.9 mm, 51 parts (35 on the bottom side), 50 nets.
