the-mad-hatters/defcon2024badge/firmware/src/display/Images.h

#ifndef IMAGES_H
#define IMAGES_H

#include <stdint.h>
#include <U8g2lib.h>

#define EYE_WIDTH  85
#define EYE_HEIGHT 64
const uint8_t eye[] PROGMEM = {
    0x00, 0x00, 0x00, 0xe0, 0xff, 0xff, 0x01, 0x00, 0x00, 0x00, 0x00, 0x00, 0x00, 0x00, 0xff, 0xff,
    0xff, 0x3f, 0x00, 0x00, 0x00, 0x00, 0x00, 0x00, 0xe0, 0xff, 0xff, 0xff, 0xff, 0x01, 0x00, 0x00,
    0x00, 0x00, 0x00, 0xfc, 0xff, 0xff, 0xff, 0xff, 0x0f, 0x00, 0x00, 0x00, 0x00, 0x00, 0xff, 0xff,
    0xff, 0xff, 0xff, 0x7f, 0x00, 0x00, 0x00, 0x00, 0x80, 0xff, 0xff, 0xe0, 0xe7, 0xff, 0xff, 0x01,
    0x00, 0x00, 0x00, 0xe0, 0xff, 0x0f, 0xff, 0xff, 0xfe, 0xff, 0x07, 0x00, 0x00, 0x00, 0xf0, 0xff,
    0xe1, 0xff, 0xff, 0xf7, 0xff, 0x0f, 0x00, 0x00, 0x00, 0xf8, 0x7f, 0xf8, 0x8f, 0xe1, 0x9f, 0xff,
    0x3f, 0x00, 0x00, 0x00, 0xfc, 0x1f, 0xfe, 0xfe, 0x7f, 0x7f, 0xfe, 0x7f, 0x00, 0x00, 0x00, 0xff,
    0x07, 0xbf, 0xff, 0xff, 0xff, 0xf9, 0xff, 0x00, 0x00, 0x80, 0xff, 0xc3, 0xef, 0xff, 0xff, 0xff,
    0xe3, 0xff, 0x01, 0x00, 0x80, 0xff, 0xe0, 0xfb, 0x07, 0xc0, 0xff, 0x8f, 0xff, 0x03, 0x00, 0xc0,
    0x7f, 0xf0, 0xff, 0x01, 0x00, 0xff, 0x1f, 0xff, 0x0f, 0x00, 0xe0, 0x3f, 0xf8, 0xff, 0x00, 0x00,
    0xfc, 0x3f, 0xfc, 0x1f, 0x00, 0xf0, 0x1f, 0xbc, 0x7f, 0x00, 0x00, 0xf8, 0xff, 0xf8, 0x3f, 0x00,
    0xf0, 0x0f, 0xfe, 0x3f, 0x00, 0x00, 0xf0, 0xff, 0xe1, 0x3f, 0x00, 0xf8, 0x07, 0xff, 0x1f, 0x00,
    0x00, 0xe0, 0xff, 0xc3, 0x7f, 0x00, 0xfc, 0x83, 0xff, 0x0f, 0x00, 0x00, 0xc0, 0xff, 0x87, 0xff,
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
    uint8_t width;
    uint8_t height;
};

// Array of images
const ImageData IMAGES[] = {
    {ImageID::EYE, eye, EYE_WIDTH, EYE_HEIGHT},
    {ImageID::EYE_V2, eye_v2, EYE_V2_WIDTH, EYE_V2_HEIGHT},
    {ImageID::ROCK, rock, ROCK_WIDTH, ROCK_HEIGHT},
};

#endif // IMAGES_H
