the-mad-hatters/defcon2024badge/(commit log)

2024-06-25 Working code for some of the functionality
    I don't have everything ported over quite yet due to messing around with
    too many other aspects of this but the code here at least works and
    doesn't _appear_ to have any random panics, etc. so I might as well get
    this up so others can see it. I'll have a lot more incoming both to
    match existing functionality in the original arduino code as well as to
    improve things further.
    [DisplayManager.cpp, DisplayManager.h, Home.hpp, Images.h, LedBase.h]
2024-06-27 Add brightness control for main LED ring
2024-06-29 Some more helpers in the display manager
    I figured it would be useful to be able to prompt a user with some
    options so I made a method to be able to render a prompt with some
    options and then since I saw that the v5 Arduino code has text input for
    the user's handle I figured I'd implement something that can do that...
    I actually didn't look closely at what it looks like in the sketch and
    instead just implemented my own concept for how to do text entry. We can
    change things however we need though
    [DisplayManager.cpp, DisplayManager.h]
2024-06-29 Refactored code for scenes
    Starting to incorporate the color palettes as in the v5 sketch.
    Abstracted a couple helper methods into `SceneBase`
2024-07-03 Refactored the scene handling code
    The LED scene code is no longer built such that you have to implement a
    separate class... it now just uses configuration defined for each scene
    and abstracts the rest. Also, I don't know why yet but some of the
    component handling stuff is no longer working... I'll debug that
    [DisplayManager.cpp, DisplayManager.h, Home.hpp, LedBase.h, LedHandler.h]
2024-07-04 Touch input fixes and component refinements
    I figured out the dumb issue I caused with touch inputs not working
    right and fixed it... also made it less error prone for future
    modifications by using maps to keep track of input pins, LEDs, and
    associated 0-offset indices
    [DisplayManager.cpp, DisplayManager.h, Home.hpp, TouchHandler.cpp, TouchHandler.h, util.cpp, util.h]
2024-07-04 Major Home mode refactor to do menus better
    I redid a ton of the Home mode to implement submenu support and make it
    look cleaner. You can now select LED modes as well by navigating through
    them and selecting what you want to change it to.
    Navigation is:
    - Handshake 1: enter/exit (brings up the menu in Home mode)
    - Handshake 2: up/left
    - Handshake 3: down/right
    - Handshake 4: select
    Special handling:
    In the "Display Handle" mode you press handshake 4 to edit your
    handle. Due to the limited supply of inputs I got creative. Here are
    the additional usages:
    - press handshakes 2 and 3 simultaneously for backspace while in
    text edit mode
    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
2024-07-04 Update SceneManager.h
    added American Jesus led mode
2024-07-04 Update SceneManager.cpp
    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
2024-07-04 Update Home.hpp
    add american jesus led mode to menu
2024-07-04 Update ScenePalettes.h
    added gone clear led palettes
2024-07-04 Update SceneManager.h
    add gone clear led mode
2024-07-04 Update SceneManager.cpp
    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
2024-07-04 Update Home.hpp
    add gone clear led mode to menu
2024-07-05 Cleanup and small bugfix
    I accidentally was saving menuIndex in the Home mode when the user
    canceled/exited the menu which was setting it to -1. This made the list
    component unhappy and it didn't want to render... maybe that's another
    bug I should fix
    [Home.hpp]
2024-07-05 Lots of changes/fixes + new modes added
    Added the revelation, and magic 8 ball modes as well as fixing a number
    of things... particularly around scrolling text and random deadlocks
    that would happen due to FastLED
    [DisplayManager.cpp, DisplayManager.h, Handle.hpp, LedBase.h, Magic8Ball.hpp, MessageMode.hpp, Revelation.hpp]
2024-07-05 Missed a change while resolving merge conflict in last commit
    [Home.hpp]
2024-07-05 Update ScenePalettes.h
    fine tune palettes.. hopefully better battery life
2024-07-05 Update SceneManager.cpp
    adjust led timing
2024-07-05 Update config.h
    adjust led brightness..
2024-07-05 more led modes, change to stay in led menu while selecting modes
2024-07-06 Switched to levels of Hell
2024-07-06 Lots more changes + Mad Hatter mode
    The Mad Hatter mode still has some bugs to work out but I should get
    sleep. Here's the latest code I have with tons of changes.
    [DisplayManager.cpp, DisplayManager.h, Handle.hpp, Home.hpp, MadHatterMeter.hpp]
2024-07-06 Finished getting Mad Hatter Meter working
    A fair number of changes to fix the mode and hopefully have everything
    working now
    [DisplayManager.cpp, DisplayManager.h, MadHatterMeter.hpp, MessageMode.hpp]
2024-07-09 Several changes
    - Changed the NSFW mode to be a global thing rather than a per-mode
    thing. Once you set it from anywhere it is set to the selected state
    for any mode
    - Made the repeat rate for when you press and hold an input shorter so
    that you can scroll more quickly through things
    [About.hpp, DisplayManager.h, Handle.hpp, Home.hpp]
2024-07-09 Misc. stuff
    - Get the version from a version.h header
    - Bug fixes
    [About.hpp, DisplayManager.cpp, DisplayManager.h, version.h]
2024-07-09 Added option to use password for NSFW prompt
    I defaulted it to use the password option for now but it's easily
    selectable by changing the #define for `NSFW_PROMPT_TYPE` in
    BadgeMode.h if you want to switch back to the activate/deactivate prompt
    I'm versioning this as 1.3.0 and including new firmware images in the
    builds/ directory
2024-07-10 Add offsets for UI rendering
    We needed a way to add at least a Y offset because the displays we have
    aren't aligned super well to the PCB cutout. This adds that support and
    sets a 4px Y offset so that things _look_ vertically centered.
    While I was in there I also implemented a feature I had forgotten about
    with the text entry component to make the cursor remain on screen when
    the text is too long for the screen width (ie. render the entered text
    with a negative X offset so that the text and cursor can still be seen).
    I'm also removing the `builds` directory and instead switching to tagged
    releases with proper GitHub releases that contain the firmware archives.
    [DisplayManager.cpp, DisplayManager.h, Home.hpp, version.h]
